adrienkohlbecker/6502_mainboard_v3/README.md

# 6502 mainboard v3

## Board

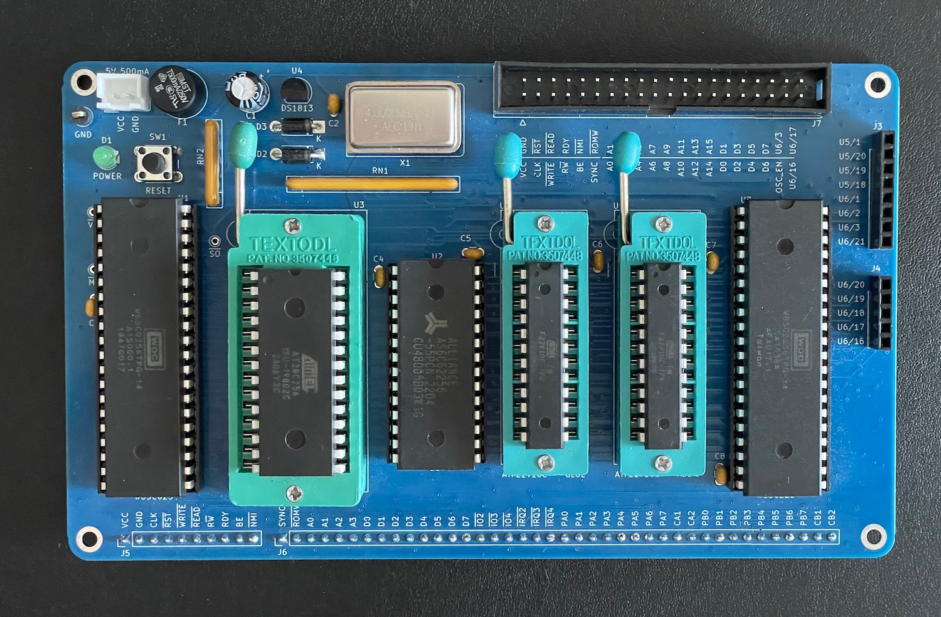
[picture p1: images/board.jpg]
board


## Schematic

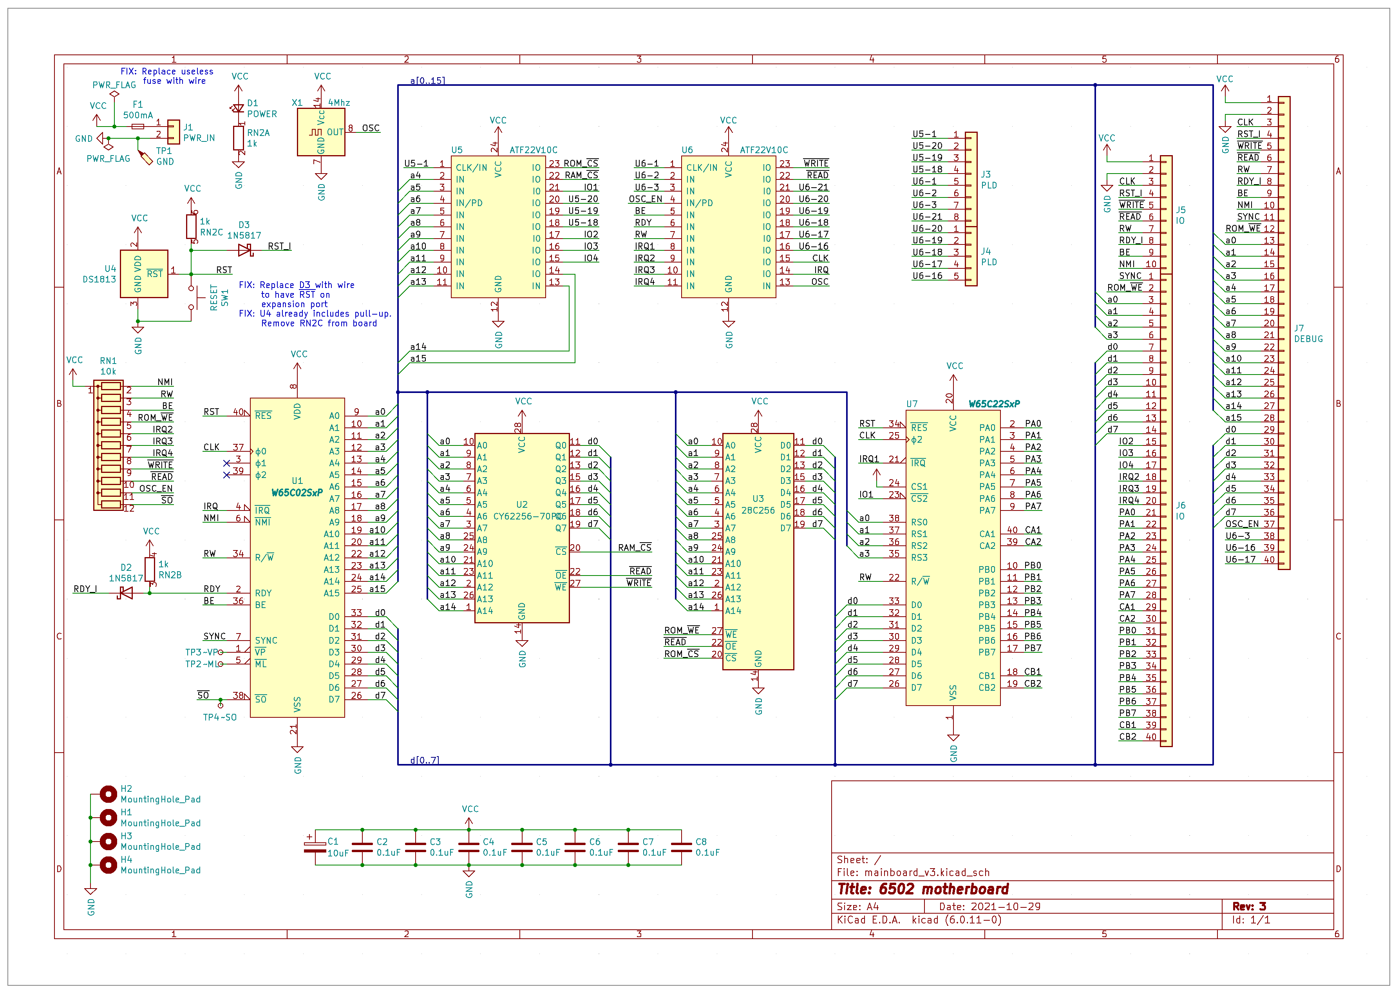
[picture p2: images/schematic.png]
schematic
