adrienkohlbecker/6502_mainboard_v3/mainboard_v3.pdf

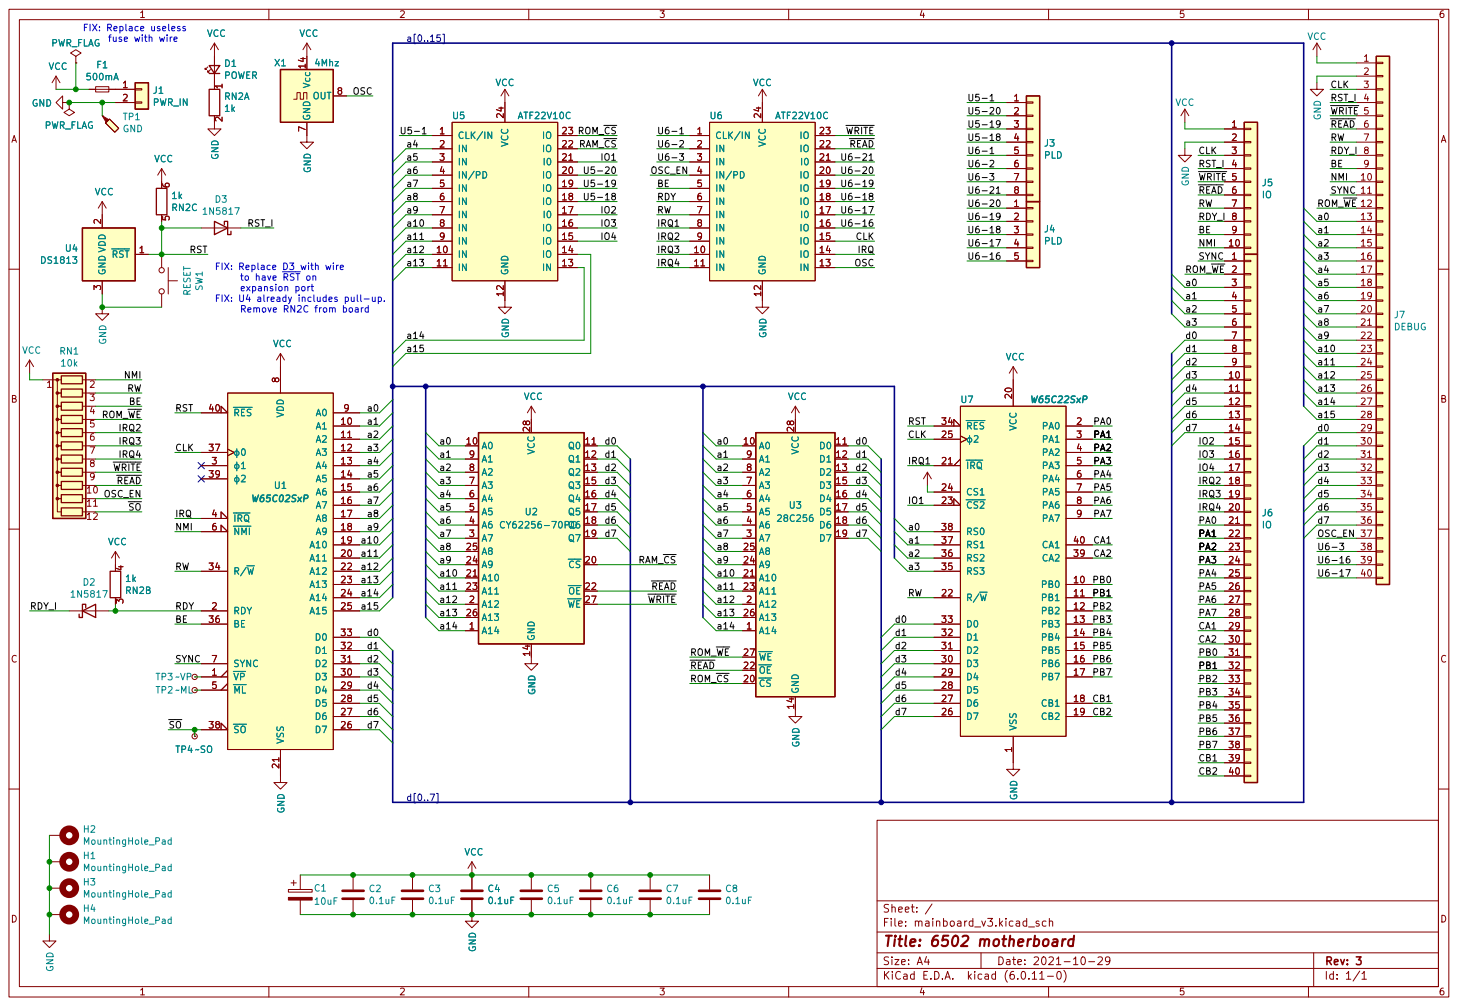
[picture p3: page 1]

VCCGND VSS
VCC GND 12 VCC 24 CLK/IN 1

VCCGND Vcc 14 GND

FIX: Replace D3 with wire
to have ~{RST}on
d4 RST
