adrienkohlbecker/6502_mainboard_v3/mainboard_v3.kicad_pcb

## KiCad design mainboard_v3.kicad_pcb (2023-06-06)

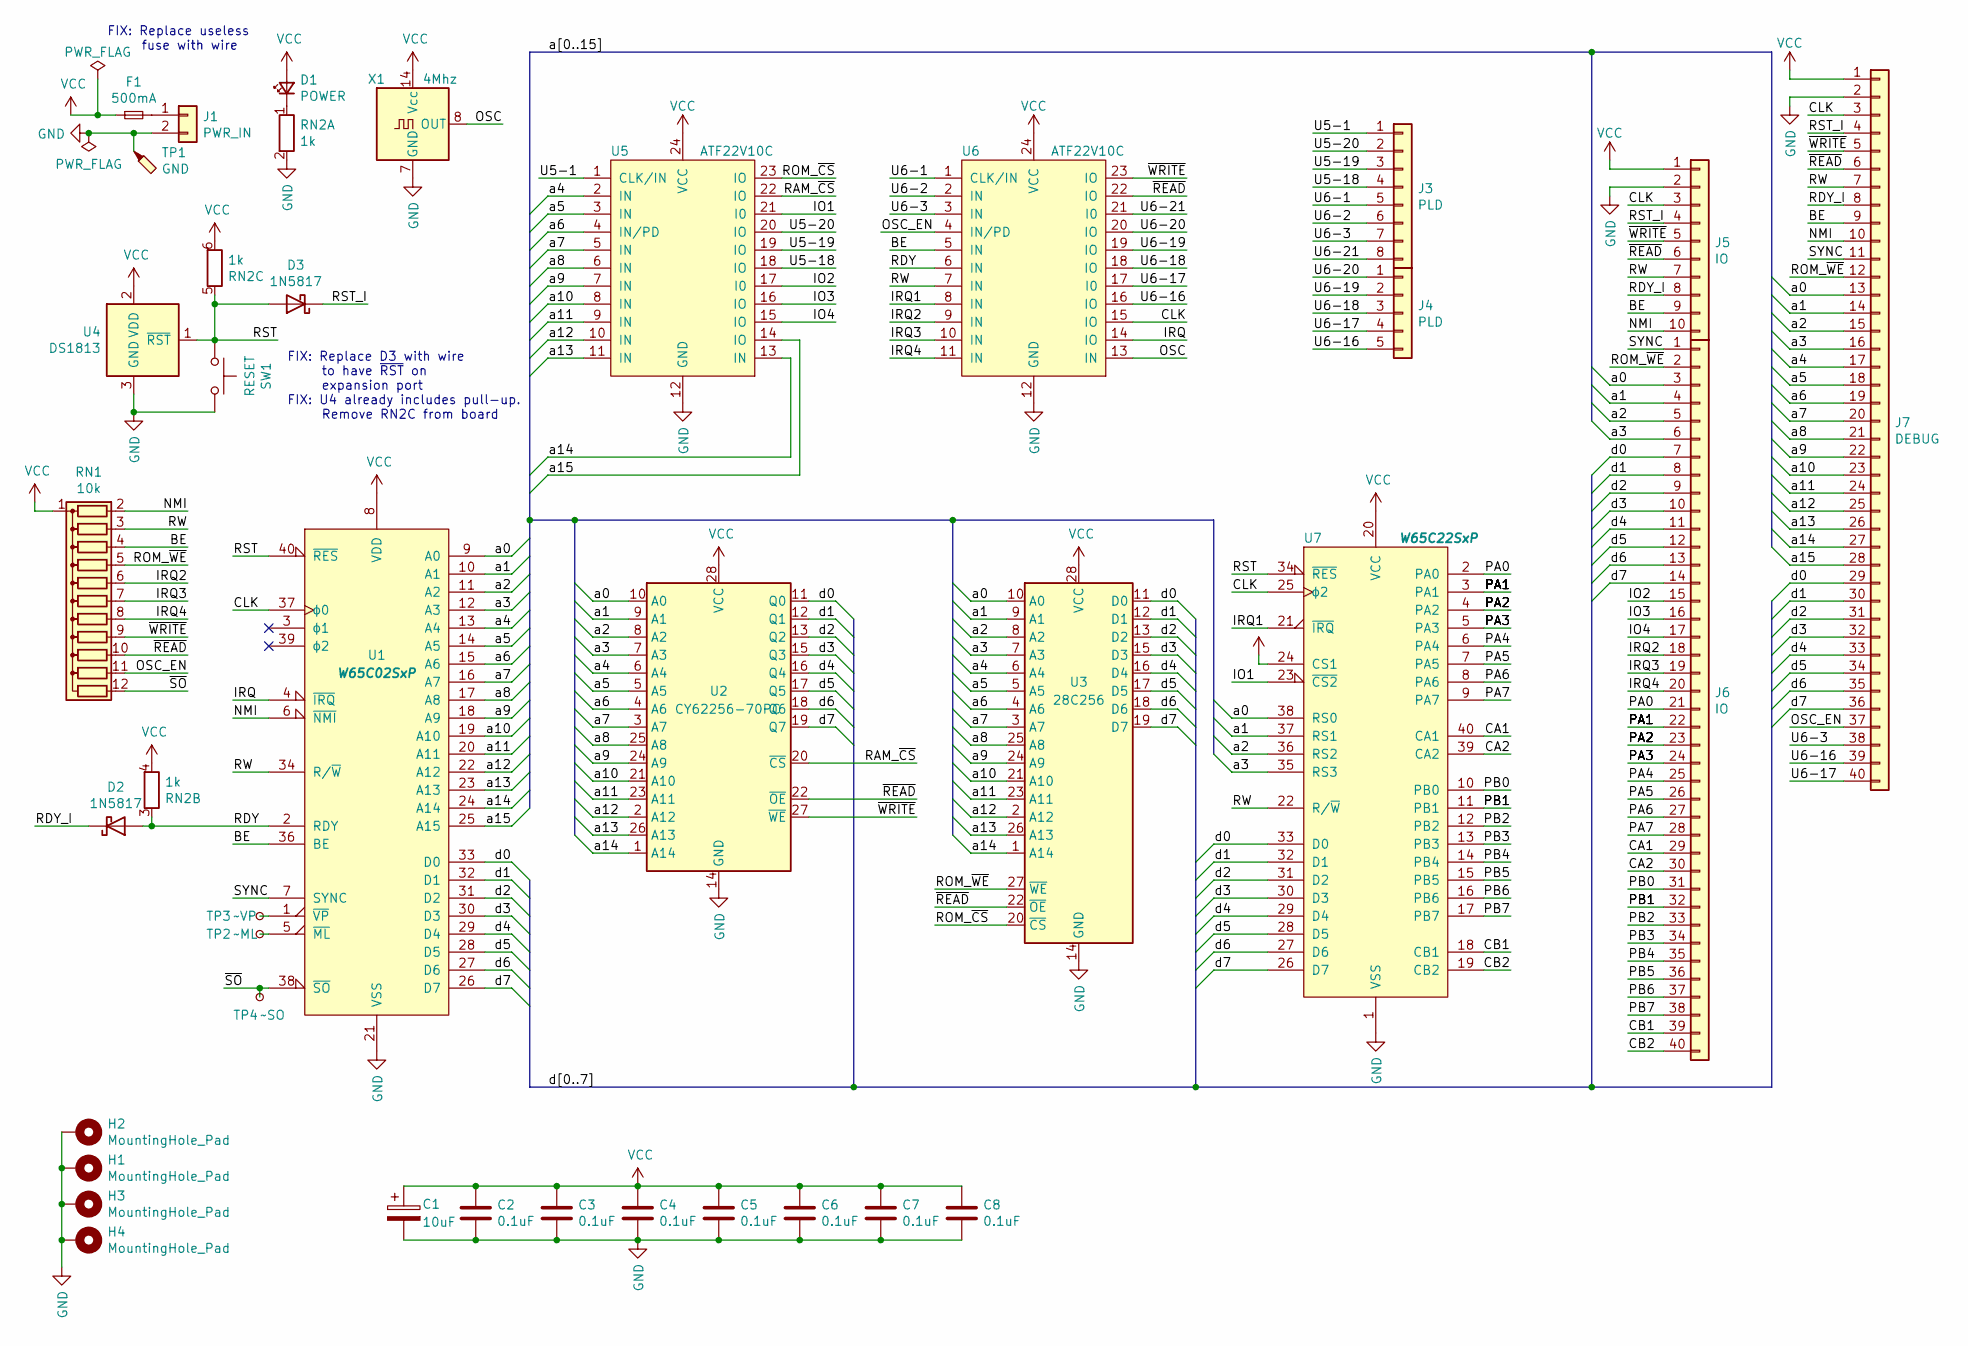
[picture p4: schematic mainboard_v3.kicad_sch, 6502 motherboard]

Parts:
C1: 10uF; CP_Radial_D6.3mm_P2.50mm
C2, C3, C4, C5, C6, C7, C8: 0.1uF; C_Disc_D3.0mm_W1.6mm_P2.50mm
D1: POWER; LED_D3.0mm
D2, D3: 1N5817; D_DO-41_SOD81_P7.62mm_Horizontal
F1: 500mA; Fuse_Littelfuse_372_D8.50mm
H1, H2, H3, H4: MountingHole_Pad; MountingHole_2.7mm_M2.5_DIN965_Pad
J1: PWR_IN; JST_EH_B2B-EH-A_1x02_P2.50mm_Vertical
J3: PLD; PinSocket_1x08_P2.54mm_Vertical
J4: PLD; PinSocket_1x05_P2.54mm_Vertical
J5: IO; PinHeader_1x10_P2.54mm_Vertical
J6: IO; PinHeader_1x40_P2.54mm_Vertical
J7: DEBUG; IDC-Header_2x20_P2.54mm_Vertical
RN1: 10k; R_Array_SIP12
RN2: 1k; R_Array_SIP6
SW1: RESET; SW_PUSH_6mm
TP1: GND; TestPoint_Loop_D2.60mm_Drill1.6mm_Beaded
TP2: ~ML; TestPoint_THTPad_D1.5mm_Drill0.7mm
TP3: ~VP; TestPoint_THTPad_D1.5mm_Drill0.7mm
TP4: ~SO; TestPoint_THTPad_D1.5mm_Drill0.7mm
U1: W65C02SxP; DIP-40_W15.24mm
U2: CY62256-70PC; DIP-28_W15.24mm
U3: 28C256; DIP_Socket-28_W11.9_W12.7_W15.24_W17.78_W18.5_3M_228-1277-0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
U4: DS1813; TO-92_Inline
U5, U6: ATF22V10C; DIP_Socket-24_W4.3_W5.08_W7.62_W10.16_W10.9_3M_224-5248-00-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
U7: W65C22SxP; DIP-40_W15.24mm
X1: 4Mhz; Oscillator_DIP-14

Connections:
/BE: J5.9, J7.9, RN1.4 (R3), U1.36 (BE), U6.5 (IN)
/CA1: J6.29, U7.40 (CA1)
/CA2: J6.30, U7.39 (CA2)
/CB1: J6.39, U7.18 (CB1)
/CB2: J6.40, U7.19 (CB2)
/CLK: J5.3, J7.3, U1.37 (ϕ0), U6.15 (IO), U7.25 (ϕ2)
/IO1: U5.21 (I0), U7.23 (~CS2)
/IO2: J6.15, U5.17 (I0)
/IO3: J6.16, U5.16 (IO)
/IO4: J6.17, U5.15 (IO)
/IRQ: U1.4 (~IRQ), U6.14 (IO)
/IRQ1: U6.8 (IN), U7.21 (~IRQ)
/IRQ2: J6.18, RN1.6 (R5), U6.9 (IN)
/IRQ3: J6.19, RN1.7 (R6), U6.10 (IN)
/IRQ4: J6.20, RN1.8 (R7), U6.11 (IN)
/NMI: J5.10, J7.10, RN1.2 (R1), U1.6 (~NMI)
/OSC: U6.13 (IN), X1.8 (OUT)
/OSC_EN: J7.37, RN1.11 (R10), U6.4 (IN/PD)
/PA0: J6.21, U7.2 (PA0)
/PA1: J6.22, U7.3 (PA1)
/PA2: J6.23, U7.4 (PA2)
/PA3: J6.24, U7.5 (PA3)
/PA4: J6.25, U7.6 (PA4)
/PA5: J6.26, U7.7 (PA5)
/PA6: J6.27, U7.8 (PA6)
/PA7: J6.28, U7.9 (PA7)
/PB0: J6.31, U7.10 (PB0)
/PB1: J6.32, U7.11 (PB1)
/PB2: J6.33, U7.12 (PB2)
/PB3: J6.34, U7.13 (PB3)
/PB4: J6.35, U7.14 (PB4)
/PB5: J6.36, U7.15 (PB5)
/PB6: J6.37, U7.16 (PB6)
/PB7: J6.38, U7.17 (PB7)
/RAM_~CS: U2.20 (~CS), U5.22 (IO)
/RDY: D2.2 (A), RN2.3 (R2.1), U1.2 (RDY), U6.6 (IN)
/RDY_I: D2.1 (K), J5.8, J7.8
/ROM_~CS: U3.20 (~CS), U5.23 (IO)
/ROM_~WE: J6.2, J7.12, RN1.5 (R4), U3.27 (~WE)
/RST: D3.2 (A), RN2.5 (R3.1), SW1.1, U1.40 (~RES), U4.1 (~RST), U7.34 (~RES)
/RST_I: D3.1 (K), J5.4, J7.4
/RW: J5.7, J7.7, RN1.3 (R2), U1.34 (R/~W), U6.7 (IN), U7.22 (R/~W)
/SYNC: J6.1, J7.11, U1.7 (SYNC)
/U5-1: J3.1, U5.1 (CLK/IN)
/U5-18: J3.4, U5.18 (IO)
/U5-19: J3.3, U5.19 (IO)
/U5-20: J3.2, U5.20 (IO)
/U6-1: J3.5, U6.1 (CLK/IN)
/U6-2: J3.6, U6.2 (IN)
/U6-3: J3.7, J7.38, U6.3 (IN)
/U6-16: J4.5, J7.39, U6.16 (IO)
/U6-17: J4.4, J7.40, U6.17 (I0)
/U6-18: J4.3, U6.18 (IO)
/U6-19: J4.2, U6.19 (IO)
/U6-20: J4.1, U6.20 (IO)
/U6-21: J3.8, U6.21 (I0)
/a0: J6.3, J7.13, U1.9 (A0), U2.10 (A0), U3.10 (A0), U7.38 (RS0)
/a1: J6.4, J7.14, U1.10 (A1), U2.9 (A1), U3.9 (A1), U7.37 (RS1)
/a2: J6.5, J7.15, U1.11 (A2), U2.8 (A2), U3.8 (A2), U7.36 (RS2)
/a3: J6.6, J7.16, U1.12 (A3), U2.7 (A3), U3.7 (A3), U7.35 (RS3)
/a4: J7.17, U1.13 (A4), U2.6 (A4), U3.6 (A4), U5.2 (IN)
/a5: J7.18, U1.14 (A5), U2.5 (A5), U3.5 (A5), U5.3 (IN)
/a6: J7.19, U1.15 (A6), U2.4 (A6), U3.4 (A6), U5.4 (IN/PD)
/a7: J7.20, U1.16 (A7), U2.3 (A7), U3.3 (A7), U5.5 (IN)
/a8: J7.21, U1.17 (A8), U2.25 (A8), U3.25 (A8), U5.6 (IN)
/a9: J7.22, U1.18 (A9), U2.24 (A9), U3.24 (A9), U5.7 (IN)
/a10: J7.23, U1.19 (A10), U2.21 (A10), U3.21 (A10), U5.8 (IN)
/a11: J7.24, U1.20 (A11), U2.23 (A11), U3.23 (A11), U5.9 (IN)
/a12: J7.25, U1.22 (A12), U2.2 (A12), U3.2 (A12), U5.10 (IN)
/a13: J7.26, U1.23 (A13), U2.26 (A13), U3.26 (A13), U5.11 (IN)
/a14: J7.27, U1.24 (A14), U2.1 (A14), U3.1 (A14), U5.13 (IN)
/a15: J7.28, U1.25 (A15), U5.14 (IO)
/d0: J6.7, J7.29, U1.33 (D0), U2.11 (Q0), U3.11 (D0), U7.33 (D0)
/d1: J6.8, J7.30, U1.32 (D1), U2.12 (Q1), U3.12 (D1), U7.32 (D1)
/d2: J6.9, J7.31, U1.31 (D2), U2.13 (Q2), U3.13 (D2), U7.31 (D2)
/d3: J6.10, J7.32, U1.30 (D3), U2.15 (Q3), U3.15 (D3), U7.30 (D3)
/d4: J6.11, J7.33, U1.29 (D4), U2.16 (Q4), U3.16 (D4), U7.29 (D4)
/d5: J6.12, J7.34, U1.28 (D5), U2.17 (Q5), U3.17 (D5), U7.28 (D5)
/d6: J6.13, J7.35, U1.27 (D6), U2.18 (Q6), U3.18 (D6), U7.27 (D6)
/d7: J6.14, J7.36, U1.26 (D7), U2.19 (Q7), U3.19 (D7), U7.26 (D7)
/~READ: J5.6, J7.6, RN1.10 (R9), U2.22 (~OE), U3.22 (~OE), U6.22 (IO)
/~SO: RN1.12 (R11), TP4.1, U1.38 (~SO)
/~WRITE: J5.5, J7.5, RN1.9 (R8), U2.27 (~WE), U6.23 (IO)
GND: C1.2, C2.2, C3.2, C4.2, C5.2, C6.2, C7.2, C8.2, H1.1, H2.1, H3.1, H4.1, J1.2, J5.2, J7.2, RN2.2 (R1.2), SW1.2, TP1.1, U1.21 (VSS), U2.14 (GND), U3.14 (GND), U4.3 (GND), U5.12 (GND), U6.12 (GND), U7.1 (VSS), X1.7 (GND)
unnamed: D1.1 (K), RN2.1 (R1.1)
unnamed: F1.2, J1.1
unnamed: TP2.1, U1.5 (~ML)
unnamed: TP3.1, U1.1 (~VP)
VCC: C1.1, C2.1, C3.1, C4.1, C5.1, C6.1, C7.1, C8.1, D1.2 (A), F1.1, J5.1, J7.1, RN1.1 (common), RN2.4 (R2.2), RN2.6 (R3.2), U1.8 (VDD), U2.28 (VCC), U3.28 (VCC), U4.2 (VDD), U5.24 (VCC), U6.24 (VCC), U7.20 (VCC), U7.24 (CS1), X1.14 (Vcc)

Notes on the sheet:
FIX: Replace D3 with wire to have ~{RST} on expansion port FIX: U4 already includes pull-up. Remove RN2C from board
FIX: Replace useless fuse with wire

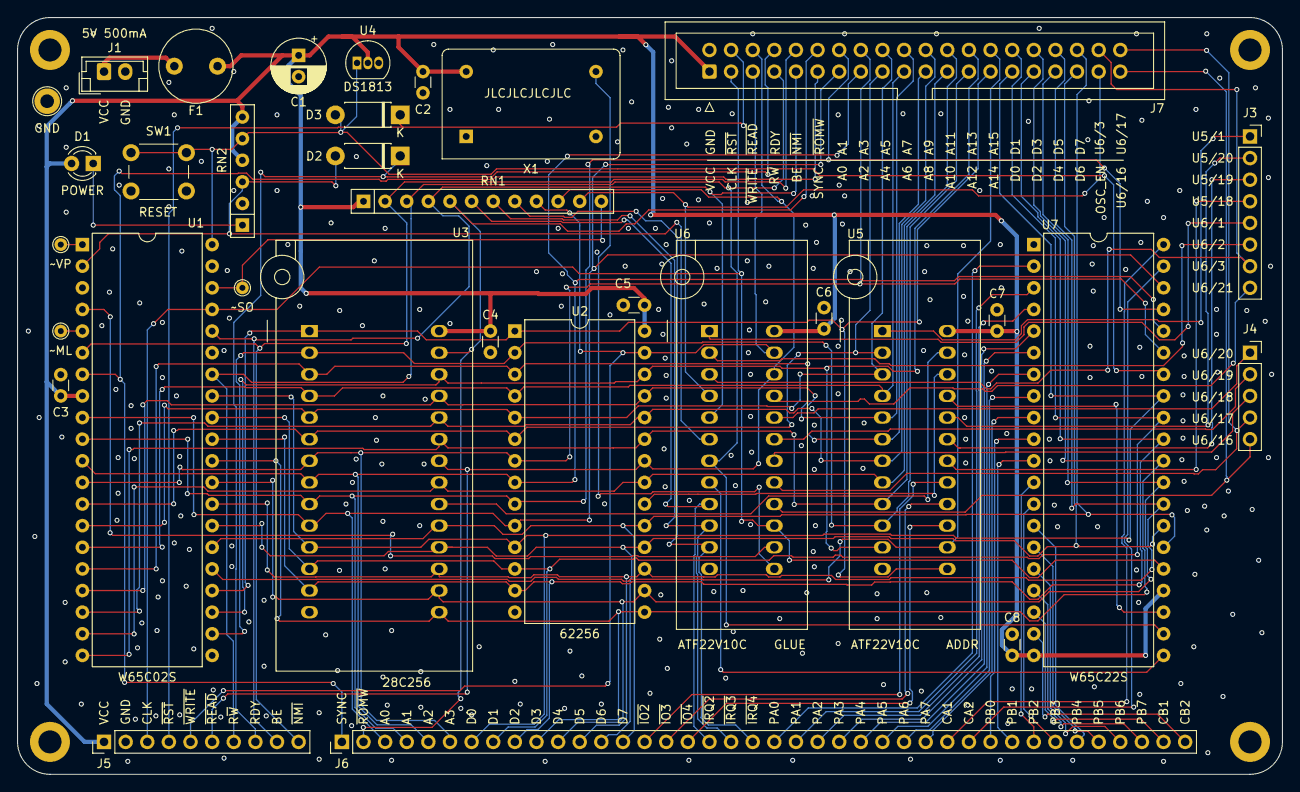
[picture p5: board mainboard_v3.kicad_pcb from above]

Board: 4 copper layers, 148.6 x 88.9 mm, 37 parts (0 on the bottom side), 89 nets.
