adrienkohlbecker/6502_mainboard_v3/(commit log)

2021-05-30 Add mainboard v3
    [gal_address_decoding.sch, mainboard_v3.kicad_pcb, mainboard_v3.sch]
2021-12-13 Mainboard v3
    [gal_address_decoding.sch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]
2023-06-06 Migrate to KiCad 6
    [mainboard_v3.kicad_pcb, mainboard_v3.kicad_sch, mainboard_v3.sch]
2023-06-06 Add schematic
2023-06-10 Fix schematic
